mattybrad/bjarkardottir2/README.md

# Bjarkardóttir 2

A synthesizer/guitar hybrid. Somewhere between a MIDI guitar and a synthesizer. Not commercially viable. A time sink. A rabbit hole. An obsession. A mistake. An exercise in blind faith. A reason to tidy the shed. A sequel to a glass cannon.
