mattybrad/bjarkardottir2/cnc/fretboard1.FCStd

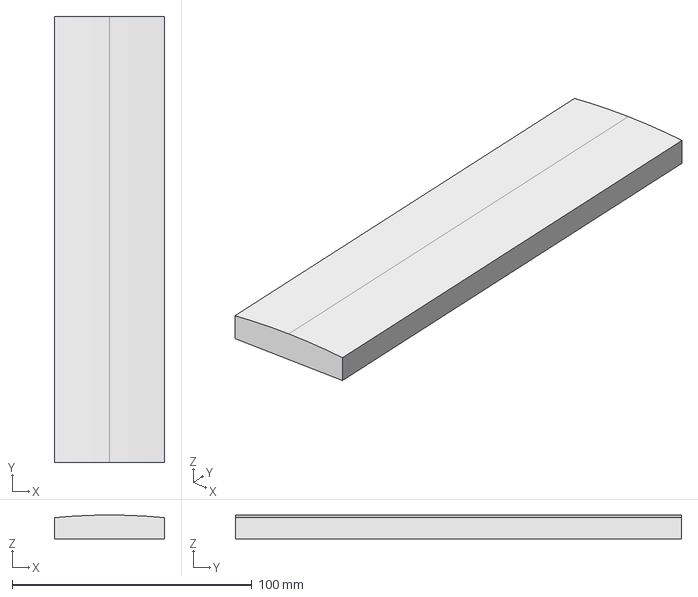
[picture p1: CAD file, 2024-11-12]
cnc/fretboard1.FCStd
46.0 x 186.0 x 10.0 mm
