mattybrad/bjarkardottir2/model/strat_with_pcb.FCStd

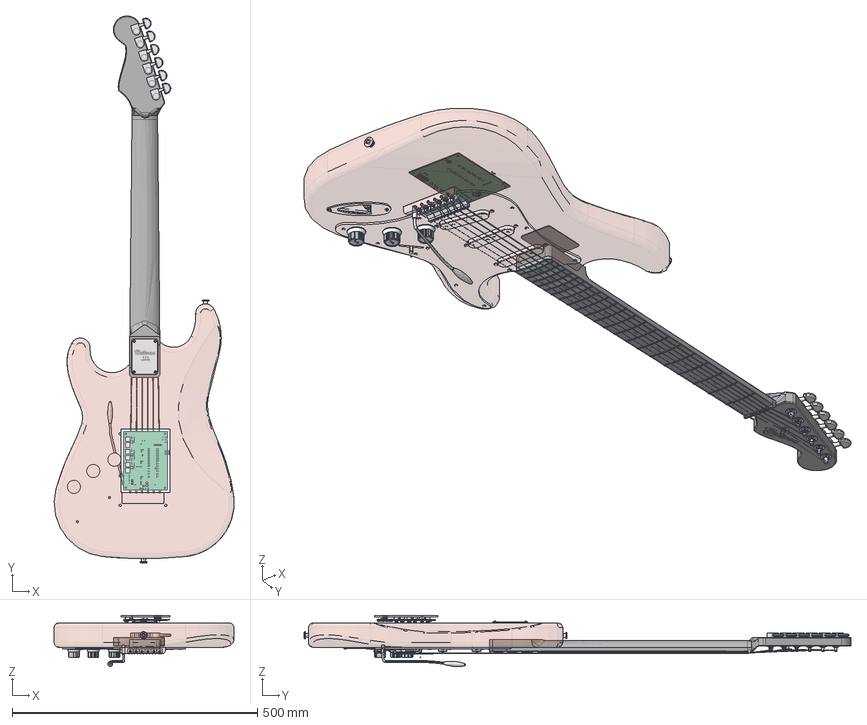
[picture p2: CAD file, 2025-02-05]
model/strat_with_pcb.FCStd
366.5 x 1115.4 x 104.3 mm
Wood
Wood001
Wood002
Neck
Neck001
Neck002
Neck003
Neck004
Neck005
Neck006
Neck007
Neck008
Neck009
Neck010
Neck011
Neck012
Neck013
Neck014
Dryer
Dryer001
Dryer003
Dryer004
Dryer006
Dryer007
Dryer009
Dryer010
Dryer012
Dryer013
Dryer015
Dryer016
Bridge
Bridge001
Bridge002
Bridge003
Bridge004
Bridge005
Peer
Peer001
Peer003
Peer004
Peer006
Peer007
Peer009
Peer010
Peer012
Peer013
Peer015
Peer016
String
String001
String002
String003
String004
String005
Knob2
Knob003
Knob
tREMOLO
Pengait Neck
cover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
