mattybrad/bjarkardottir2/pcb/fretboard/S5B-ZR-SM4A-TF.STEP

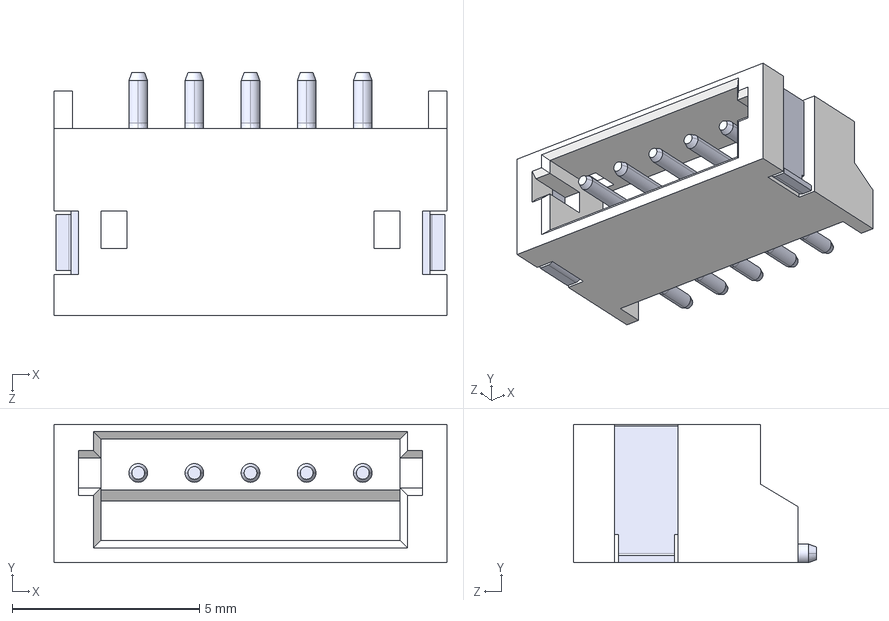
[picture p3: CAD file, 2025-02-12]
pcb/fretboard/S5B-ZR-SM4A-TF.STEP
10.5 x 3.70 x 6.50 mm
