mattybrad/bjarkardottir2/cnc/bridgecnc.FCStd

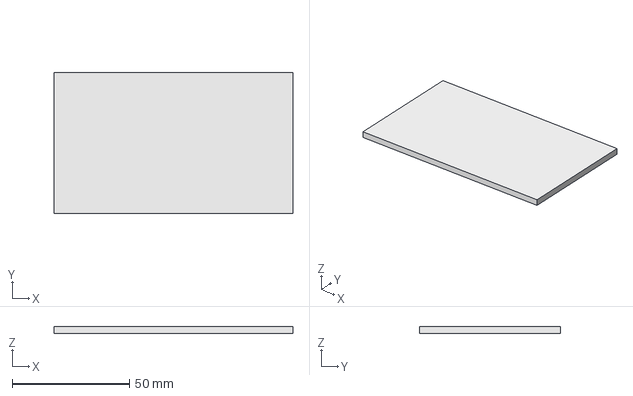
[picture p4: CAD file, 2024-11-12]
cnc/bridgecnc.FCStd
102.0 x 60.0 x 3.00 mm
