mattybrad/bjarkardottir2/cnc/bridge.FCStd

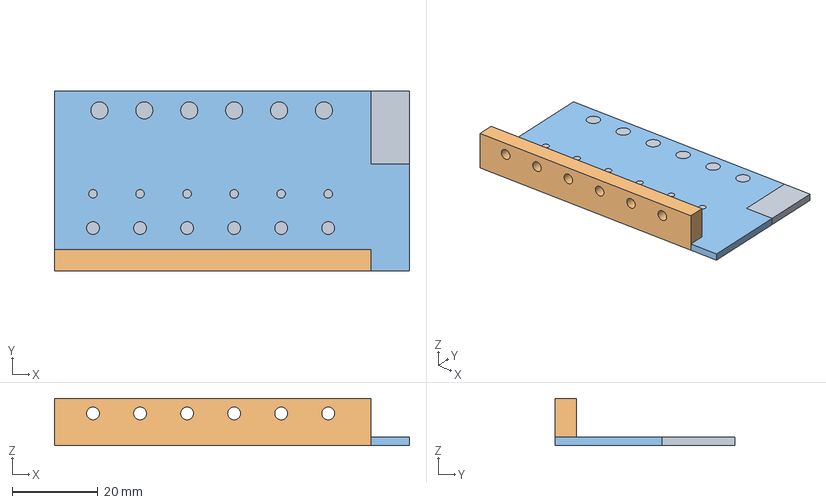
[picture p5: CAD file, 2024-11-12]
cnc/bridge.FCStd
83.0 x 42.0 x 11.0 mm
