mattybrad/bjarkardottir2/(list of files, cad)

Other CAD files:
cnc/bridge.stl
