mattybrad/bjarkardottir2/pcb/body2/body2.kicad_pcb

## KiCad design pcb/body2/body2.kicad_pcb (2025-06-07)

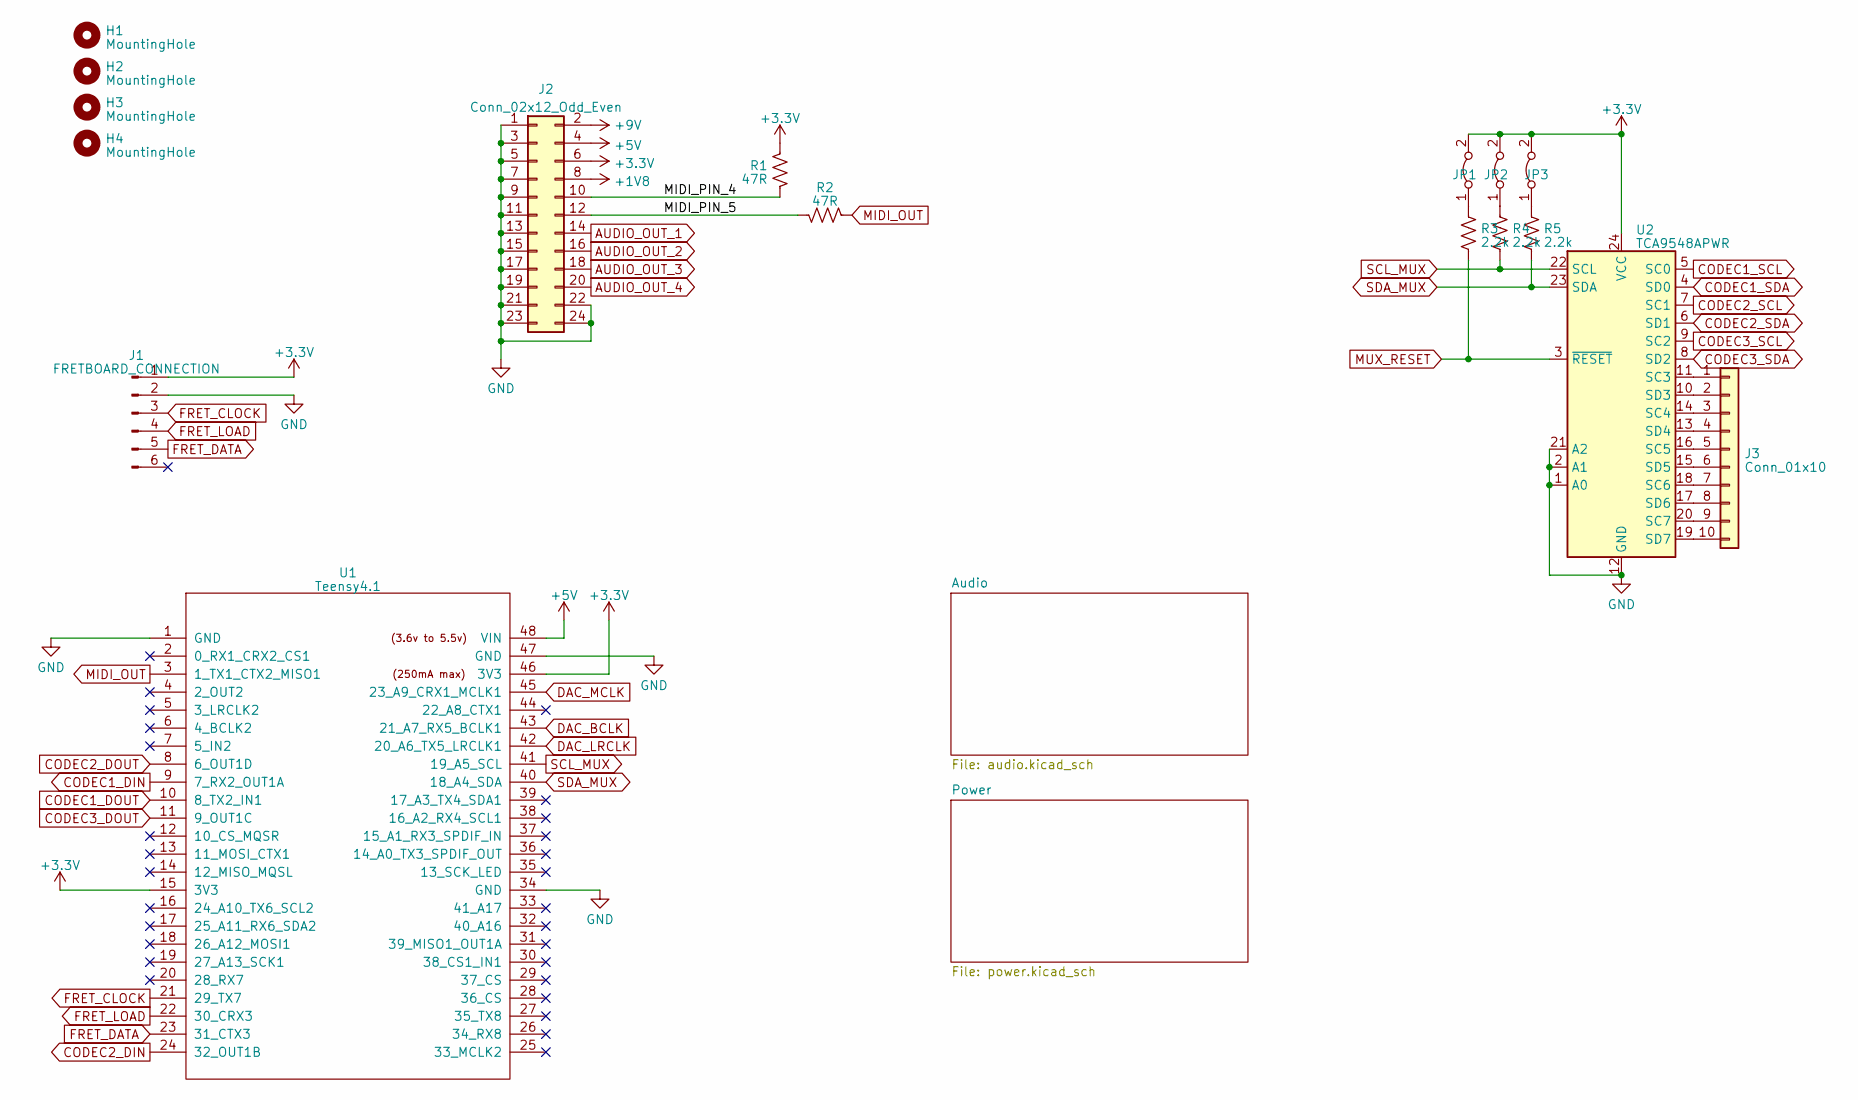
[picture p6: schematic body2.kicad_sch]

Parts:
H1, H2, H3, H4: MountingHole; MountingHole_3.2mm_M3
J1: FRETBOARD_CONNECTION; jst zh fretboard connector; LCSC C485355
J2: Conn_02x12_Odd_Even; PinHeader_2x12_P2.54mm_Vertical
J3: Conn_01x10; PinHeader_1x10_P1.27mm_Vertical
JP1, JP2, JP3: Jumper_2_Bridged; SolderJumper-2_P1.3mm_Bridged_Pad1.0x1.5mm
R1, R2: 47R; R_0603_1608Metric; LCSC C23182
R3, R4, R5: 2.2k; R_0603_1608Metric; LCSC C21190
U1: Teensy4.1; Teensy41_breakout
U2: TCA9548APWR; TSSOP-24_4.4x7.8mm_P0.65mm

Connections:
+1V8: J2.8; also elsewhere on the board
+3.3V: J1.1, J2.6, JP1.2 (B), JP2.2 (B), JP3.2 (B), R1.1, U1.15 (3V3), U1.46 (3V3), U2.24 (VCC); also elsewhere on the board
+5V: J2.4, U1.48 (VIN); also elsewhere on the board
+9V: J2.2; also elsewhere on the board
/MIDI_PIN_4: J2.10, R1.2
/MIDI_PIN_5: J2.12, R2.2
AUDIO_OUT_1: J2.14; also elsewhere on the board
AUDIO_OUT_2: J2.16; also elsewhere on the board
AUDIO_OUT_3: J2.18; also elsewhere on the board
AUDIO_OUT_4: J2.20; also elsewhere on the board
CODEC1_DIN: U1.9 (7_RX2_OUT1A); also elsewhere on the board
CODEC1_DOUT: U1.10 (8_TX2_IN1); also elsewhere on the board
CODEC1_SCL: U2.5 (SC0); also elsewhere on the board
CODEC1_SDA: U2.4 (SD0); also elsewhere on the board
CODEC2_DIN: U1.24 (32_OUT1B); also elsewhere on the board
CODEC2_DOUT: U1.8 (6_OUT1D); also elsewhere on the board
CODEC2_SCL: U2.7 (SC1); also elsewhere on the board
CODEC2_SDA: U2.6 (SD1); also elsewhere on the board
CODEC3_DOUT: U1.11 (9_OUT1C); also elsewhere on the board
CODEC3_SCL: U2.9 (SC2); also elsewhere on the board
CODEC3_SDA: U2.8 (SD2); also elsewhere on the board
DAC_BCLK: U1.43 (21_A7_RX5_BCLK1); also elsewhere on the board
DAC_LRCLK: U1.42 (20_A6_TX5_LRCLK1); also elsewhere on the board
DAC_MCLK: U1.45 (23_A9_CRX1_MCLK1); also elsewhere on the board
FRET_CLOCK: J1.3, U1.21 (29_TX7)
FRET_DATA: J1.5, U1.23 (31_CTX3)
FRET_LOAD: J1.4, U1.22 (30_CRX3)
GND: J1.2, J2.1, J2.3, J2.5, J2.7, J2.9, J2.11, J2.13, J2.15, J2.17, J2.19, J2.21, J2.22, J2.23, J2.24, U1.1 (GND), U1.34 (GND), U1.47 (GND), U2.1 (A0), U2.2 (A1), U2.12 (GND), U2.21 (A2); also elsewhere on the board
MIDI_OUT: R2.1, U1.3 (1_TX1_CTX2_MISO1)
MUX_RESET: R3.1, U2.3 (~RESET)
unnamed: J3.1, U2.11 (SC3)
unnamed: J3.2, U2.10 (SD3)
unnamed: J3.3, U2.14 (SC4)
unnamed: J3.4, U2.13 (SD4)
unnamed: J3.5, U2.16 (SC5)
unnamed: J3.6, U2.15 (SD5)
unnamed: J3.7, U2.18 (SC6)
unnamed: J3.8, U2.17 (SD6)
unnamed: J3.9, U2.20 (SC7)
unnamed: J3.10, U2.19 (SD7)
unnamed: JP1.1 (A), R3.2
unnamed: JP2.1 (A), R4.2
unnamed: JP3.1 (A), R5.2
SCL_MUX: R4.1, U1.41 (19_A5_SCL), U2.22 (SCL)
SDA_MUX: R5.1, U1.40 (18_A4_SDA), U2.23 (SDA)

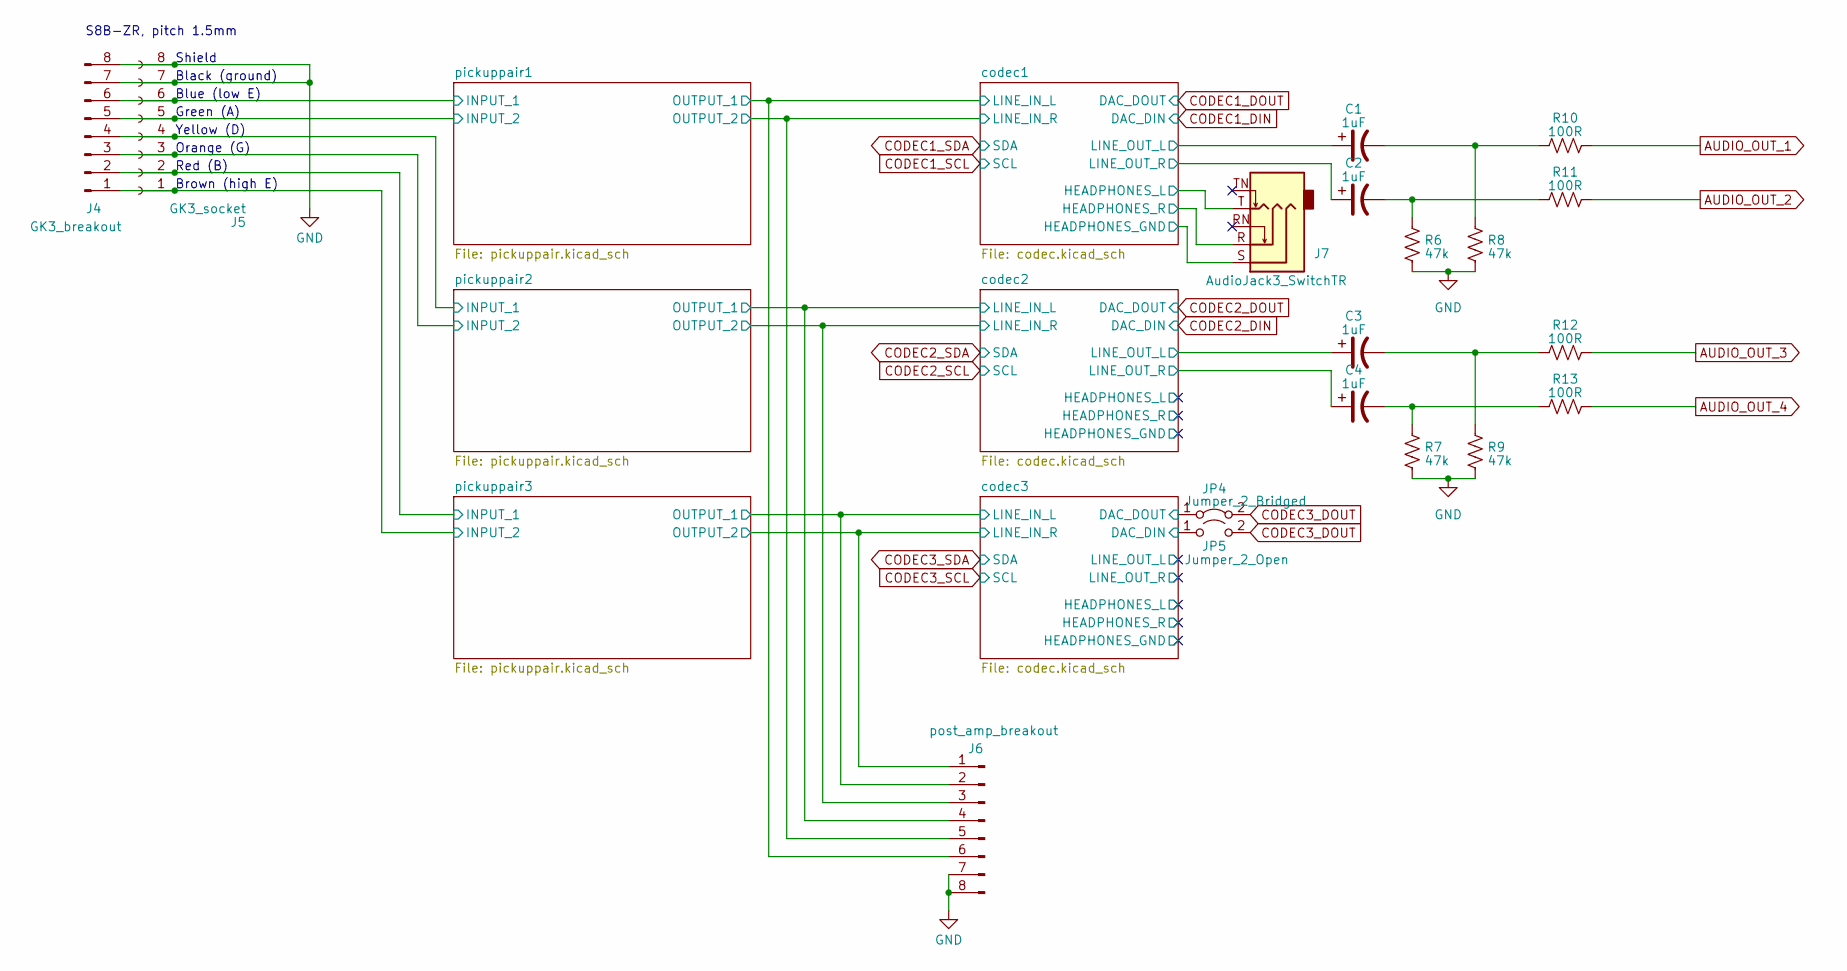
[picture p7: schematic audio.kicad_sch]

Parts:
C1, C3: 1uF; C_0603_1608Metric; LCSC C23630
C2, C4: 1uF; C_0603_1608Metric; LCSC C513735
J4: GK3_breakout; PinHeader_1x08_P2.54mm_Vertical
J5: GK3_socket; gk3 connector THT
J6: post_amp_breakout; PinHeader_1x08_P2.54mm_Vertical
J7: AudioJack3_SwitchTR; Jack_3.5mm_CUI_SJ1-3525N_Horizontal
JP4: Jumper_2_Bridged; SolderJumper-2_P1.3mm_Bridged_Pad1.0x1.5mm
JP5: Jumper_2_Open; SolderJumper-2_P1.3mm_Open_Pad1.0x1.5mm
R6, R7: 47k; R_0603_1608Metric; LCSC C22935
R8, R9: 47k; R_0603_1608Metric; LCSC C22976
R10, R11, R12, R13: 100R; R_0603_1608Metric; LCSC C22976

Connections:
/Audio/codec1/HEADPHONES_GND: J7.S; also elsewhere on the board
/Audio/codec1/HEADPHONES_L: J7.T; also elsewhere on the board
/Audio/codec1/HEADPHONES_R: J7.R; also elsewhere on the board
/Audio/codec1/LINE_IN_L: J6.6; also elsewhere on the board
/Audio/codec1/LINE_IN_R: J6.5; also elsewhere on the board
/Audio/codec1/LINE_OUT_L: C1.1; also elsewhere on the board
/Audio/codec1/LINE_OUT_R: C2.1; also elsewhere on the board
/Audio/codec2/LINE_IN_L: J6.4; also elsewhere on the board
/Audio/codec2/LINE_IN_R: J6.3; also elsewhere on the board
/Audio/codec2/LINE_OUT_L: C3.1; also elsewhere on the board
/Audio/codec2/LINE_OUT_R: C4.1; also elsewhere on the board
/Audio/codec3/DAC_DIN: JP5.1 (A); also elsewhere on the board
/Audio/codec3/DAC_DOUT: JP4.1 (A); also elsewhere on the board
/Audio/codec3/LINE_IN_L: J6.2; also elsewhere on the board
/Audio/codec3/LINE_IN_R: J6.1; also elsewhere on the board
/Audio/pickuppair1/INPUT_1: J4.6, J5.6; also elsewhere on the board
/Audio/pickuppair1/INPUT_2: J4.5, J5.5; also elsewhere on the board
/Audio/pickuppair2/INPUT_1: J4.4, J5.4; also elsewhere on the board
/Audio/pickuppair2/INPUT_2: J4.3, J5.3; also elsewhere on the board
/Audio/pickuppair3/INPUT_1: J4.2, J5.2; also elsewhere on the board
/Audio/pickuppair3/INPUT_2: J4.1, J5.1; also elsewhere on the board
AUDIO_OUT_1: R10.1; also elsewhere on the board
AUDIO_OUT_2: R11.1; also elsewhere on the board
AUDIO_OUT_3: R12.1; also elsewhere on the board
AUDIO_OUT_4: R13.1; also elsewhere on the board
CODEC3_DOUT: JP4.2 (B), JP5.2 (B); also elsewhere on the board
GND: J4.7, J4.8, J5.7, J5.8, J6.7, J6.8, R6.1, R7.1, R8.1, R9.1; also elsewhere on the board
unnamed: C1.2, R8.2, R10.2
unnamed: C2.2, R6.2, R11.2
unnamed: C3.2, R9.2, R12.2
unnamed: C4.2, R7.2, R13.2

Notes on the sheet:
Black (ground)
Yellow (D)
Brown (high E)
Red (B)
Green (A)
Orange (G)
S8B-ZR, pitch 1.5mm
Blue (low E)
Shield

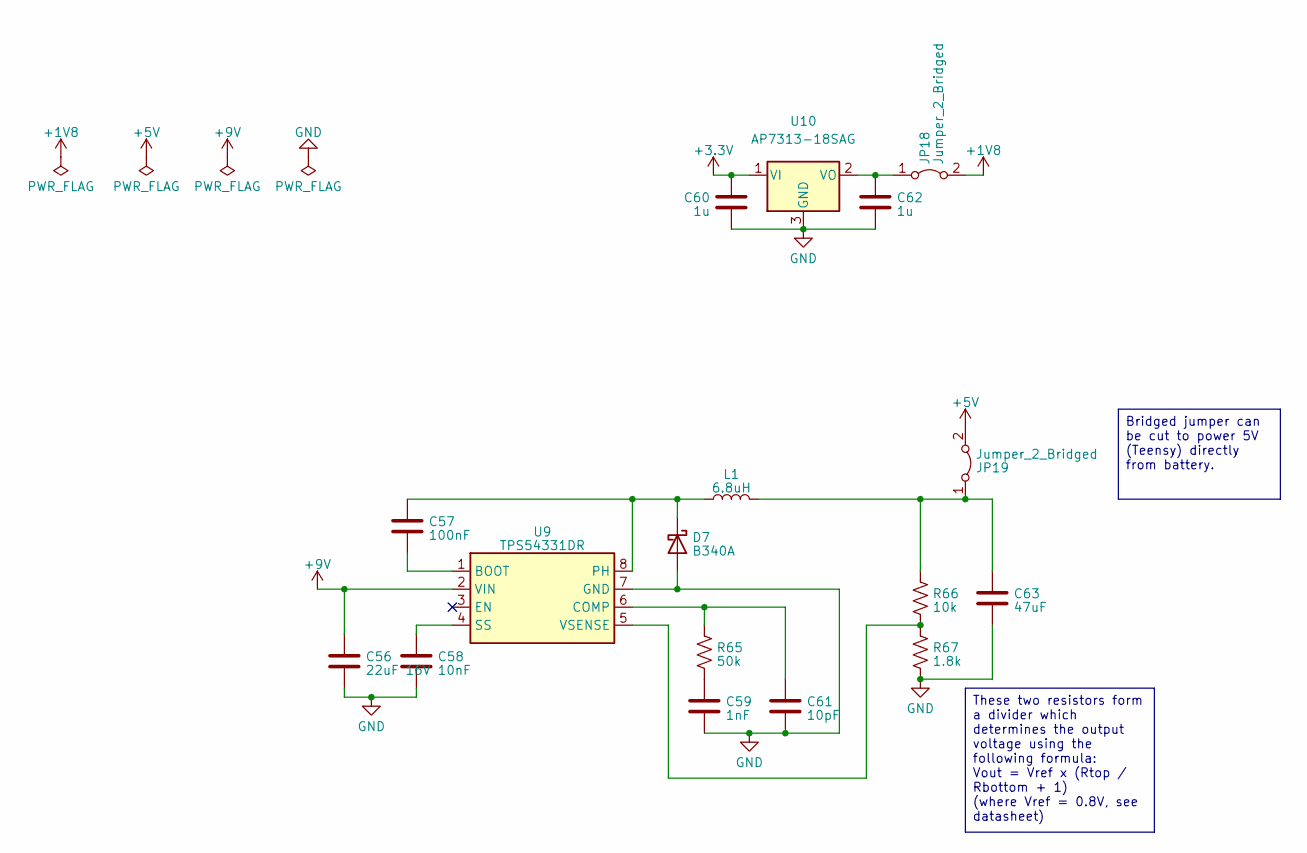
[picture p8: schematic power.kicad_sch]

Parts:
C56: 22uF 16V; C_0805_2012Metric
C57: 100nF; C_0603_1608Metric
C58: 10nF; C_0603_1608Metric
C59: 1nF; C_0603_1608Metric
C60, C62: 1u; C_0603_1608Metric
C61: 10pF; C_0603_1608Metric
C63: 47uF; C_1210_3225Metric
D7: B340A; D_SMA
JP18, JP19: Jumper_2_Bridged; SolderJumper-2_P1.3mm_Bridged_Pad1.0x1.5mm
L1: 6.8uH; L_Changjiang_FNR4020S
R65: 50k; R_0603_1608Metric
R66: 10k; R_0603_1608Metric
R67: 1.8k; R_0603_1608Metric
U9: TPS54331DR; SOIC-8_3.9x4.9mm_P1.27mm
U10: AP7313-18SAG; SOT-23

Connections:
+1V8: JP18.2 (B); also elsewhere on the board
+3.3V: C60.1, U10.1 (VI); also elsewhere on the board
+5V: JP19.2 (B); also elsewhere on the board
+9V: C56.1, U9.2 (VIN); also elsewhere on the board
GND: C56.2, C58.2, C59.2, C60.2, C61.2, C62.2, C63.2, D7.2 (A), R67.2, U9.7 (GND), U10.3 (GND); also elsewhere on the board
unnamed: C59.1, R65.2
unnamed: C57.1, D7.1 (K), L1.1, U9.8 (PH)
unnamed: C62.1, JP18.1 (A), U10.2 (VO)
unnamed: C63.1, JP19.1 (A), L1.2, R66.1
unnamed: C57.2, U9.1 (BOOT)
unnamed: C61.1, R65.1, U9.6 (COMP)
unnamed: C58.1, U9.4 (SS)
unnamed: R66.2, R67.1, U9.5 (VSENSE)

Notes on the sheet:
Bridged jumper can be cut to power 5V (Teensy) directly from battery.
These two resistors form a divider which determines the output voltage using the following formula: Vout = Vref x (Rtop / Rbottom + 1) (where Vref = 0.8V, see datasheet)

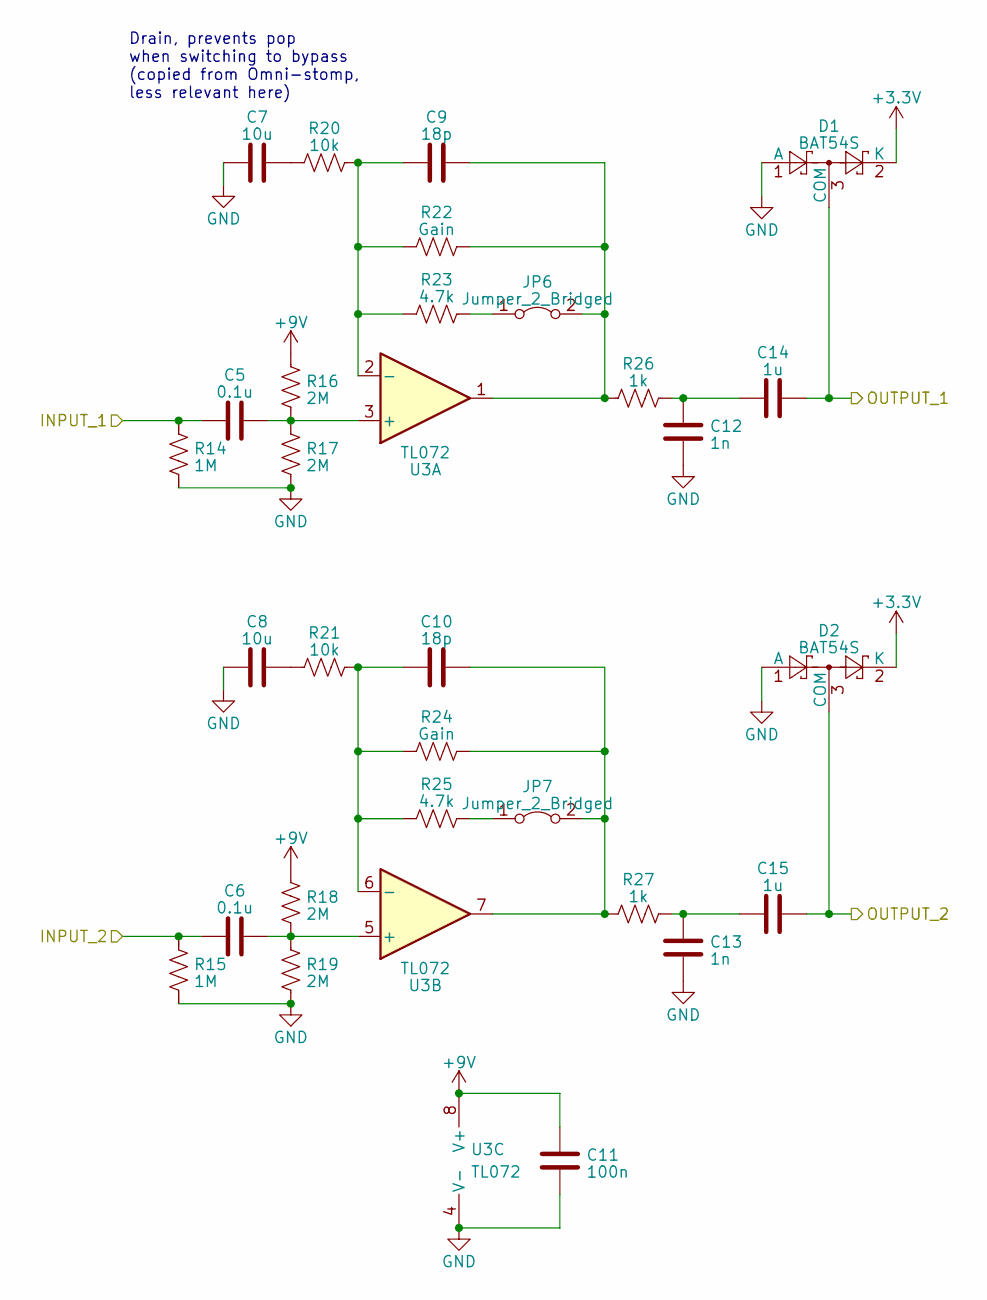
[picture p9: schematic pickuppair.kicad_sch]

Parts:
C5, C6: 0.1u; C_0603_1608Metric
C7, C8: 10u; C_0603_1608Metric
C9, C10: 18p; C_0603_1608Metric
C11: 100n; C_0603_1608Metric
C12, C13: 1n; C_0603_1608Metric
C14, C15: 1u; C_0603_1608Metric
D1, D2: BAT54S; SOT-23
JP6, JP7: Jumper_2_Bridged; SolderJumper-2_P1.3mm_Bridged_Pad1.0x1.5mm
R14, R15: 1M; R_0603_1608Metric
R16, R17, R18, R19: 2M; R_0603_1608Metric
R20, R21: 10k; R_0603_1608Metric
R22, R24: Gain; R_Axial_DIN0207_L6.3mm_D2.5mm_P7.62mm_Horizontal
R23, R25: 4.7k; R_0603_1608Metric
R26, R27: 1k; R_0603_1608Metric
U3: TL072; SOIC-8_3.9x4.9mm_P1.27mm

Connections:
+3.3V: D1.2 (K), D2.2 (K); also elsewhere on the board
+9V: C11.2, R16.1, R18.1, U3.8 (V+); also elsewhere on the board
/Audio/codec1/LINE_IN_L: C14.1, D1.3 (COM); also elsewhere on the board
/Audio/codec1/LINE_IN_R: C15.1, D2.3 (COM); also elsewhere on the board
/Audio/pickuppair1/INPUT_1: C5.1, R14.1; also elsewhere on the board
/Audio/pickuppair1/INPUT_2: C6.1, R15.1; also elsewhere on the board
GND: C7.1, C8.1, C11.1, C12.2, C13.2, D1.1 (A), D2.1 (A), R14.2, R15.2, R17.2, R19.2, U3.4 (V-); also elsewhere on the board
unnamed: C7.2, R20.1
unnamed: C8.2, R21.1
unnamed: C12.1, C14.2, R26.2
unnamed: C13.1, C15.2, R27.2
unnamed: JP6.1 (A), R23.2
unnamed: C9.2, JP6.2 (B), R22.2, R26.1, U3.1
unnamed: JP7.1 (A), R25.2
unnamed: C10.2, JP7.2 (B), R24.2, R27.1, U3.7
unnamed: C5.2, R16.2, R17.1, U3.3 (+)
unnamed: C9.1, R20.2, R22.1, R23.1, U3.2 (-)
unnamed: C6.2, R18.2, R19.1, U3.5 (+)
unnamed: C10.1, R21.2, R24.1, R25.1, U3.6 (-)

Parts of its further copies:
C18, C19, C29, C30: 10u; C_0603_1608Metric
C20, C21, C31, C32: 18p; C_0603_1608Metric
C22, C33: 100n; C_0603_1608Metric
C23, C24, C34, C35: 1n; C_0603_1608Metric
C25, C26, C36, C37: 1u; C_0603_1608Metric
C27, C28: 0.1u; C_0603_1608Metric
D3, D4, D5, D6: BAT54S; SOT-23
JP8, JP9, JP10, JP11: Jumper_2_Bridged; SolderJumper-2_P1.3mm_Bridged_Pad1.0x1.5mm
R28, R29, R42, R43: 1M; R_0603_1608Metric
R30, R31, R32, R33, R44, R45, R46, R47: 2M; R_0603_1608Metric
R34, R35, R48, R49: 10k; R_0603_1608Metric
R36, R38, R50, R52: Gain; R_Axial_DIN0207_L6.3mm_D2.5mm_P7.62mm_Horizontal
R37, R39, R51, R53: 4.7k; R_0603_1608Metric
R40, R41, R54, R55: 1k; R_0603_1608Metric
U4, U5: TL072; SOIC-8_3.9x4.9mm_P1.27mm

Connections of its further copies:
+3.3V: D3.2 (K), D4.2 (K), D5.2 (K), D6.2 (K); also elsewhere on the board
+9V: C22.2, C33.2, R30.1, R32.1, R44.1, R46.1, U4.8 (V+), U5.8 (V+); also elsewhere on the board
/Audio/codec2/LINE_IN_L: C25.1, D3.3 (COM); also elsewhere on the board
/Audio/codec2/LINE_IN_R: C26.1, D4.3 (COM); also elsewhere on the board
/Audio/codec3/LINE_IN_L: C36.1, D5.3 (COM); also elsewhere on the board
/Audio/codec3/LINE_IN_R: C37.1, D6.3 (COM); also elsewhere on the board
/Audio/pickuppair2/INPUT_1: R28.1; also elsewhere on the board
/Audio/pickuppair2/INPUT_2: R29.1; also elsewhere on the board
/Audio/pickuppair3/INPUT_1: C27.1, R42.1; also elsewhere on the board
/Audio/pickuppair3/INPUT_2: C28.1, R43.1; also elsewhere on the board
GND: C18.1, C19.1, C22.1, C23.2, C24.2, C29.1, C30.1, C33.1, C34.2, C35.2, D3.1 (A), D4.1 (A), D5.1 (A), D6.1 (A), R28.2, R29.2, R31.2, R33.2, R42.2, R43.2, R45.2, R47.2, U4.4 (V-), U5.4 (V-); also elsewhere on the board
unnamed: C18.2, R34.1
unnamed: C19.2, R35.1
unnamed: C23.1, C25.2, R40.2
unnamed: C24.1, C26.2, R41.2
unnamed: C29.2, R48.1
unnamed: C30.2, R49.1
unnamed: C34.1, C36.2, R54.2
unnamed: C35.1, C37.2, R55.2
unnamed: JP8.1 (A), R37.2
unnamed: C20.2, JP8.2 (B), R36.2, R40.1, U4.1
unnamed: JP9.1 (A), R39.2
unnamed: C21.2, JP9.2 (B), R38.2, R41.1, U4.7
unnamed: JP10.1 (A), R51.2
unnamed: C31.2, JP10.2 (B), R50.2, R54.1, U5.1
unnamed: JP11.1 (A), R53.2
unnamed: C32.2, JP11.2 (B), R52.2, R55.1, U5.7
unnamed 114: R30.2, R31.1, U4.3 (+); also elsewhere on the board
unnamed: C20.1, R34.2, R36.1, R37.1, U4.2 (-)
unnamed 116: R32.2, R33.1, U4.5 (+); also elsewhere on the board
unnamed: C21.1, R35.2, R38.1, R39.1, U4.6 (-)
unnamed: C27.2, R44.2, R45.1, U5.3 (+)
unnamed: C31.1, R48.2, R50.1, R51.1, U5.2 (-)
unnamed: C28.2, R46.2, R47.1, U5.5 (+)
unnamed: C32.1, R49.2, R52.1, R53.1, U5.6 (-)

Notes on the sheet:
Drain, prevents pop when switching to bypass (copied from Omni-stomp, less relevant here)

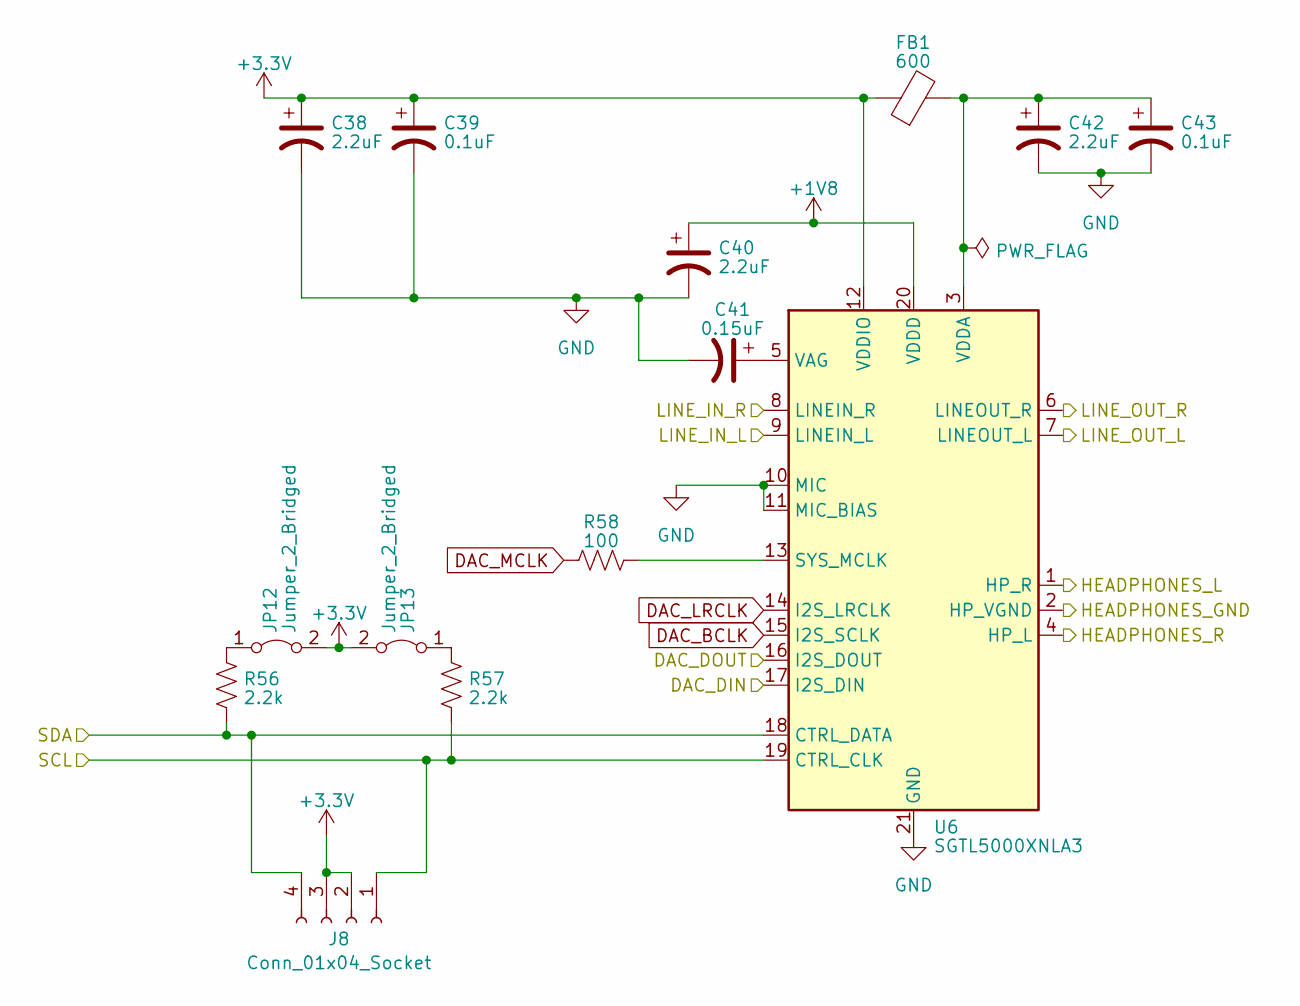
[picture p10: schematic codec.kicad_sch]

Parts:
C38, C40, C42: 2.2uF; C_0603_1608Metric
C39, C43: 0.1uF; C_0603_1608Metric
C41: 0.15uF; C_0603_1608Metric
FB1: 600; L_0603_1608Metric
J8: Conn_01x04_Socket; PinSocket_1x04_P1.27mm_Vertical
JP12, JP13: Jumper_2_Bridged; SolderJumper-2_P1.3mm_Bridged_Pad1.0x1.5mm
R56, R57: 2.2k; R_0603_1608Metric; LCSC C21190
R58: 100; R_0603_1608Metric
U6: SGTL5000XNLA3; QFN-20-1EP_3x3mm_P0.4mm_EP1.65x1.65mm

Connections:
+1V8: C40.1, U6.20 (VDDD); also elsewhere on the board
+3.3V: C38.1, C39.1, FB1.1, J8.2, J8.3, JP12.2 (B), JP13.2 (B), U6.12 (VDDIO); also elsewhere on the board
/Audio/codec1/HEADPHONES_GND: U6.2 (HP_VGND); also elsewhere on the board
/Audio/codec1/HEADPHONES_L: U6.1 (HP_R); also elsewhere on the board
/Audio/codec1/HEADPHONES_R: U6.4 (HP_L); also elsewhere on the board
/Audio/codec1/LINE_IN_L: U6.9 (LINEIN_L); also elsewhere on the board
/Audio/codec1/LINE_IN_R: U6.8 (LINEIN_R); also elsewhere on the board
/Audio/codec1/LINE_OUT_L: U6.7 (LINEOUT_L); also elsewhere on the board
/Audio/codec1/LINE_OUT_R: U6.6 (LINEOUT_R); also elsewhere on the board
CODEC1_DIN: U6.17 (I2S_DIN); also elsewhere on the board
CODEC1_DOUT: U6.16 (I2S_DOUT); also elsewhere on the board
CODEC1_SCL: J8.1, R57.1, U6.19 (CTRL_CLK); also elsewhere on the board
CODEC1_SDA: J8.4, R56.1, U6.18 (CTRL_DATA); also elsewhere on the board
DAC_BCLK: U6.15 (I2S_SCLK); also elsewhere on the board
DAC_LRCLK: U6.14 (I2S_LRCLK); also elsewhere on the board
DAC_MCLK: R58.2; also elsewhere on the board
GND: C38.2, C39.2, C40.2, C41.2, C42.2, C43.2, U6.10 (MIC), U6.11 (MIC_BIAS), U6.21 (GND); also elsewhere on the board
unnamed: JP12.1 (A), R56.2
unnamed: JP13.1 (A), R57.2
unnamed: R58.1, U6.13 (SYS_MCLK)
unnamed: C41.1, U6.5 (VAG)
unnamed: C42.1, C43.1, FB1.2, U6.3 (VDDA)

Parts of its further copies:
C44, C46, C48, C50, C52, C54: 2.2uF; C_0603_1608Metric
C45, C49, C51, C55: 0.1uF; C_0603_1608Metric
C47, C53: 0.15uF; C_0603_1608Metric
FB2, FB3: 600; L_0603_1608Metric
J9, J10: Conn_01x04_Socket; PinSocket_1x04_P1.27mm_Vertical
JP14, JP15, JP16, JP17: Jumper_2_Bridged; SolderJumper-2_P1.3mm_Bridged_Pad1.0x1.5mm
R59, R60, R62, R63: 2.2k; R_0603_1608Metric; LCSC C21190
R61, R64: 100; R_0603_1608Metric
U7, U8: SGTL5000XNLA3; QFN-20-1EP_3x3mm_P0.4mm_EP1.65x1.65mm

Connections of its further copies:
+1V8: C46.1, C52.1, U7.20 (VDDD), U8.20 (VDDD); also elsewhere on the board
+3.3V: C44.1, C45.1, C50.1, C51.1, FB2.1, FB3.1, J9.2, J9.3, J10.2, J10.3, JP14.2 (B), JP15.2 (B), JP16.2 (B), JP17.2 (B), U7.12 (VDDIO), U8.12 (VDDIO); also elsewhere on the board
/Audio/codec2/HEADPHONES_GND: U7.2 (HP_VGND)
/Audio/codec2/HEADPHONES_L: U7.1 (HP_R)
/Audio/codec2/HEADPHONES_R: U7.4 (HP_L)
/Audio/codec2/LINE_IN_L: U7.9 (LINEIN_L); also elsewhere on the board
/Audio/codec2/LINE_IN_R: U7.8 (LINEIN_R); also elsewhere on the board
/Audio/codec2/LINE_OUT_L: U7.7 (LINEOUT_L); also elsewhere on the board
/Audio/codec2/LINE_OUT_R: U7.6 (LINEOUT_R); also elsewhere on the board
/Audio/codec3/DAC_DIN: U8.17 (I2S_DIN); also elsewhere on the board
/Audio/codec3/DAC_DOUT: U8.16 (I2S_DOUT); also elsewhere on the board
/Audio/codec3/HEADPHONES_GND: U8.2 (HP_VGND)
/Audio/codec3/HEADPHONES_L: U8.1 (HP_R)
/Audio/codec3/HEADPHONES_R: U8.4 (HP_L)
/Audio/codec3/LINE_IN_L: U8.9 (LINEIN_L); also elsewhere on the board
/Audio/codec3/LINE_IN_R: U8.8 (LINEIN_R); also elsewhere on the board
/Audio/codec3/LINE_OUT_L: U8.7 (LINEOUT_L)
/Audio/codec3/LINE_OUT_R: U8.6 (LINEOUT_R)
CODEC2_DIN: U7.17 (I2S_DIN); also elsewhere on the board
CODEC2_DOUT: U7.16 (I2S_DOUT); also elsewhere on the board
CODEC2_SCL: J9.1, R60.1, U7.19 (CTRL_CLK); also elsewhere on the board
CODEC2_SDA: J9.4, R59.1, U7.18 (CTRL_DATA); also elsewhere on the board
CODEC3_SCL: J10.1, R63.1, U8.19 (CTRL_CLK); also elsewhere on the board
CODEC3_SDA: J10.4, R62.1, U8.18 (CTRL_DATA); also elsewhere on the board
DAC_BCLK: U7.15 (I2S_SCLK), U8.15 (I2S_SCLK); also elsewhere on the board
DAC_LRCLK: U7.14 (I2S_LRCLK), U8.14 (I2S_LRCLK); also elsewhere on the board
DAC_MCLK: R61.2, R64.2; also elsewhere on the board
GND: C44.2, C45.2, C46.2, C47.2, C48.2, C49.2, C50.2, C51.2, C52.2, C53.2, C54.2, C55.2, U7.10 (MIC), U7.11 (MIC_BIAS), U7.21 (GND), U8.10 (MIC), U8.11 (MIC_BIAS), U8.21 (GND); also elsewhere on the board
unnamed: JP14.1 (A), R59.2
unnamed: JP15.1 (A), R60.2
unnamed: JP16.1 (A), R62.2
unnamed: JP17.1 (A), R63.2
unnamed: R61.1, U7.13 (SYS_MCLK)
unnamed: C47.1, U7.5 (VAG)
unnamed: C48.1, C49.1, FB2.2, U7.3 (VDDA)
unnamed: R64.1, U8.13 (SYS_MCLK)
unnamed: C53.1, U8.5 (VAG)
unnamed: C54.1, C55.1, FB3.2, U8.3 (VDDA)

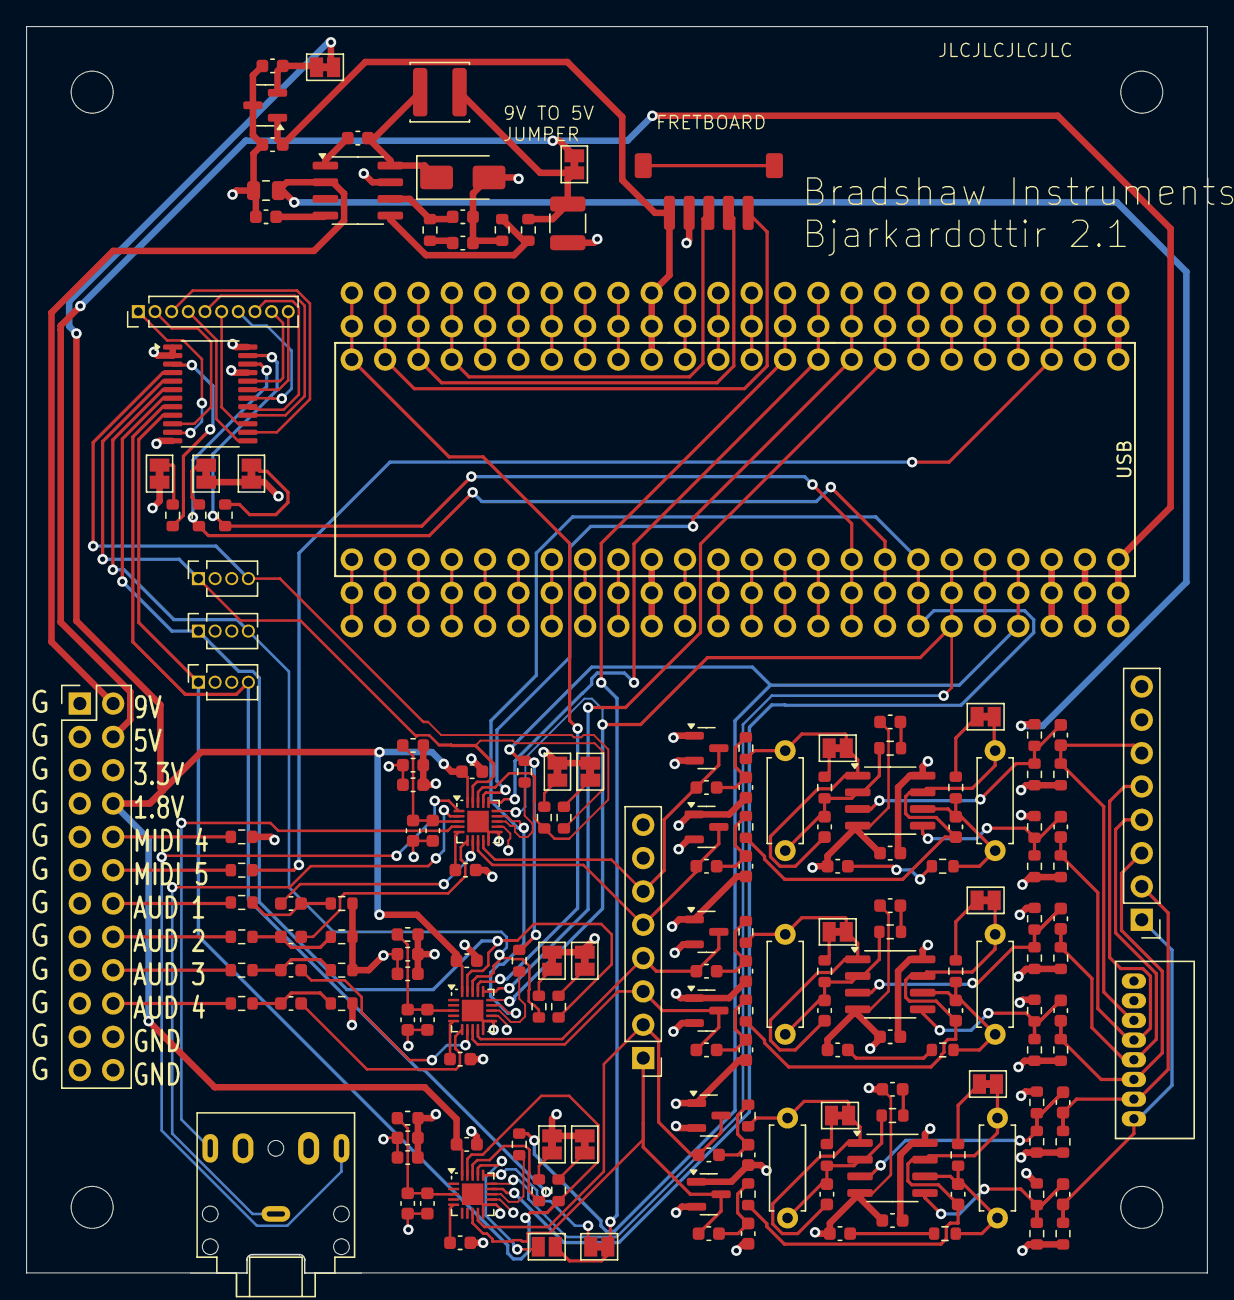
[picture p11: board body2.kicad_pcb from above]

Board: 4 copper layers, 90.0 x 95.0 mm, 184 parts (0 on the bottom side), 129 nets.

Other parts of the board:
C16, C17: 0.1u; C_0603_1608Metric

Their connections:
/Audio/pickuppair2/INPUT_1: C16.1; also elsewhere on the board
/Audio/pickuppair2/INPUT_2: C17.1; also elsewhere on the board
unnamed 114: C16.2; also elsewhere on the board
unnamed 116: C17.2; also elsewhere on the board
