mattybrad/bjarkardottir2/pcb/body/body.kicad_pcb

## KiCad design pcb/body/body.kicad_pcb (2025-02-17)

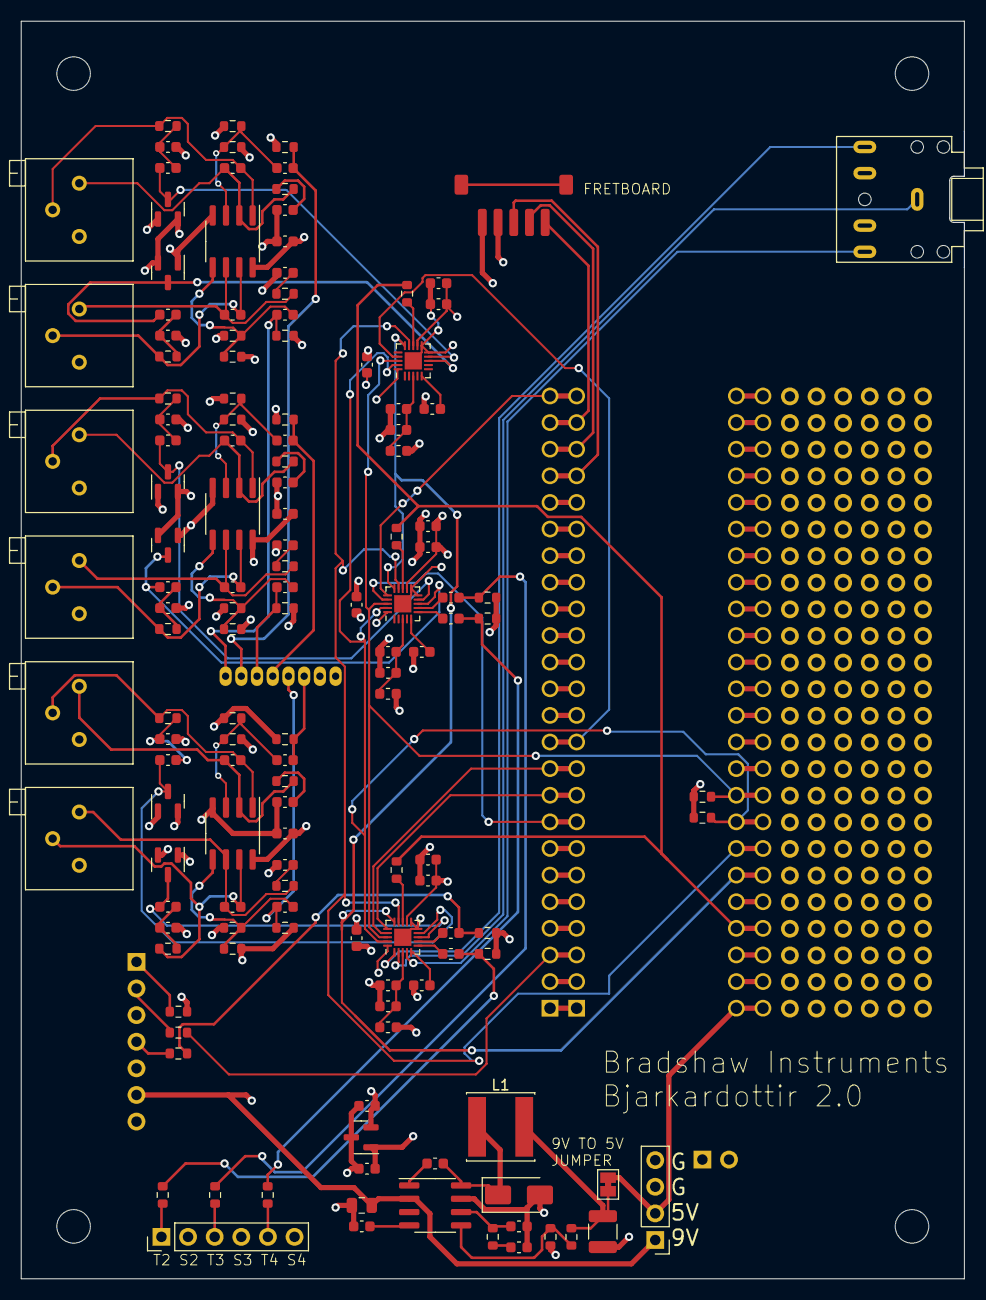
[picture p12: board body.kicad_pcb from above]

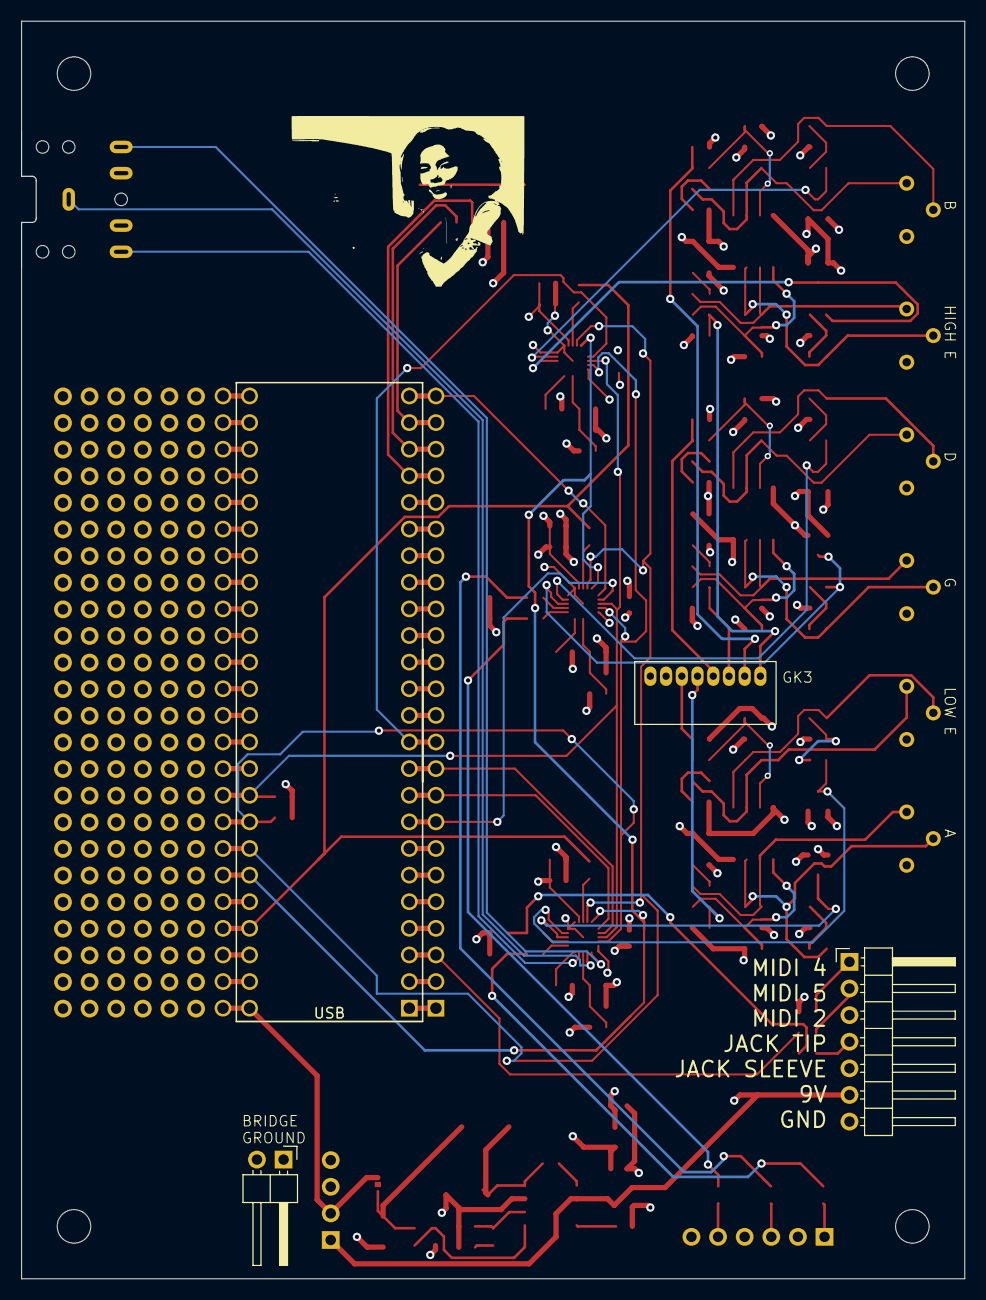
[picture p13: board body.kicad_pcb from below]

Board: 4 copper layers, 90.0 x 120.0 mm, 293 parts (4 on the bottom side), 94 nets.

Parts:
C1, C2, C3, C4: 1uF; C_0603_1608Metric
C5, C6, C16, C17, C27, C28: 0.1u; C_0603_1608Metric
C7, C8, C18, C19, C29, C30: 10u; C_0603_1608Metric
C9, C10, C20, C21, C31, C32: 18p; C_0603_1608Metric
C11, C22, C33: 100n; C_0603_1608Metric
C12, C13, C23, C24, C34, C35: 1n; C_0603_1608Metric
C14, C15, C25, C26, C36, C37, C60, C62: 1u; C_0603_1608Metric
C38, C40, C42, C44, C46, C48, C50, C52, C54: 2.2uF; C_0603_1608Metric
C39, C43, C45, C49, C51, C55: 0.1uF; C_0603_1608Metric
C41, C47, C53: 0.15uF; C_0603_1608Metric
C56: 22uF 16V; C_0805_2012Metric
C57: 100nF; C_0603_1608Metric
C58: 10nF; C_0603_1608Metric
C59: 1nF; C_0603_1608Metric
C61: 10pF; C_0603_1608Metric
C63: 47uF; C_1210_3225Metric
D1, D2, D3, D4, D5, D6: BAT54S; SOT-23
D7: B340A; D_SMA
FB1, FB2, FB3: 600; L_0603_1608Metric
H1, H2, H3, H4: MountingHole; MountingHole_3.2mm_M3
J1: FRETBOARD_CONNECTION; jst zh fretboard connector
J2: BRIDGE_GROUND; PinHeader_1x02_P2.54mm_Horizontal
J3: GK3_socket; gk3 connector THT
J4: AudioJack3_SwitchTR; Jack_3.5mm_CUI_SJ1-3525N_Horizontal
J5: External_connections; PinHeader_1x07_P2.54mm_Horizontal
J6: OUTPUTS_234; PinHeader_1x06_P2.54mm_Vertical
J7: Battery_Power; PinHeader_1x04_P2.54mm_Vertical
JP1: Jumper_2_Bridged; SolderJumper-2_P1.3mm_Bridged_Pad1.0x1.5mm
L1: 6.8uH; L_Sunlord_SWPA6045S
PB1, PB2, PB3, PB4, PB5, PB6, PB7, PB8, PB9, PB10, PB11, PB12, PB13, PB14, PB15, PB16, PB17, PB18, PB19, PB20, PB21, PB22, PB23, PB24, PB25, PB26, PB27, PB28, PB29, PB30, PB31, PB32, PB33, PB34, PB35, PB36, PB37, PB38, PB39, PB40, PB41, PB42, PB43, PB44, PB45, PB46, PB47, PB48, PB49, PB50, PB51, PB52, PB53, PB54, PB55, PB56, PB57, PB58, PB59, PB60, PB61, PB62, PB63, PB64, PB65, PB66, PB67, PB68, PB69, PB70, PB71, PB72, PB73, PB74, PB75, PB76, PB77, PB78, PB79, PB80, PB81, PB82, PB83, PB84, PB85, PB86, PB87, PB88, PB89, PB90, PB91, PB92, PB93, PB94, PB95, PB96, PB97, PB98, PB99, PB100, PB101, PB102, PB103, PB104, PB105, PB106, PB107, PB108, PB109, PB110, PB111, PB112, PB113, PB114, PB115, PB116, PB117, PB118, PB119, PB120, PB121, PB122, PB123, PB124, PB125, PB126, PB127, PB128, PB129, PB130, PB131, PB132, PB133, PB134, PB135, PB136, PB137, PB138, PB139, PB140, PB141, PB142, PB143, PB144: perfboard_pin; perfboard pin
R1, R2: 2.2k; R_0603_1608Metric
R3, R4, R6, R7: 47k; R_0603_1608Metric
R5, R8: 47R; R_0603_1608Metric
R9, R10, R11, R12: 100R; R_0603_1608Metric
R13, R14, R23, R24, R33, R34: 1M; R_0603_1608Metric
R15, R16, R17, R18, R25, R26, R27, R28, R35, R36, R37, R38: 2M; R_0603_1608Metric
R19, R20, R29, R30, R39, R40, R47: 10k; R_0603_1608Metric
R21, R22, R31, R32, R41, R42: 1k; R_0603_1608Metric
R43, R44, R45: 100; R_0603_1608Metric
R46: 50k; R_0603_1608Metric
R48: 1.8k; R_0603_1608Metric
RV1, RV2, RV3, RV4, RV5, RV6: 10k; Potentiometer_Bourns_3296P_Horizontal
U1: Teensy4.1; Teensy41_breakout
U2, U3, U4: TL072; SOIC-8_3.9x4.9mm_P1.27mm
U5, U6, U7: SGTL5000XNLA3; QFN-20-1EP_3x3mm_P0.4mm_EP1.65x1.65mm
U8: TPS54331DR; SOIC-8_3.9x4.9mm_P1.27mm
U9: AP7313-18SAG; SOT-23

Connections:
+1V8: C40.1, C46.1, C52.1, C62.1, U5.20 (VDDD), U6.20 (VDDD), U7.20 (VDDD), U9.2 (VO)
+3.3V: C38.1, C39.1, C44.1, C45.1, C50.1, C51.1, C60.1, D1.2 (K), D2.2 (K), D3.2 (K), D4.2 (K), D5.2 (K), D6.2 (K), FB1.1, FB2.1, FB3.1, J1.1, R1.2, R2.2, R5.1, U1.15 (3V3), U1.46 (3V3), U5.12 (VDDIO), U6.12 (VDDIO), U7.12 (VDDIO), U9.1 (VI)
+5V: J7.2, JP1.2 (B), U1.48 (VIN)
+9V: C11.2, C22.2, C33.2, C56.1, J5.6, J7.1, R15.1, R17.1, R25.1, R27.1, R35.1, R37.1, U2.8 (V+), U3.8 (V+), U4.8 (V+), U8.2 (VIN)
/MIDI_PIN_4: J5.1, R5.2
/MIDI_PIN_5: J5.2, R8.2
/codec1/HEADPHONES_GND: J4.S, U5.2 (HP_VGND)
/codec1/HEADPHONES_L: J4.T, U5.1 (HP_R)
/codec1/HEADPHONES_R: J4.R, U5.4 (HP_L)
/codec1/LINE_IN_L: C14.1, D1.3 (COM), U5.9 (LINEIN_L)
/codec1/LINE_IN_R: C15.1, D2.3 (COM), U5.8 (LINEIN_R)
/codec1/LINE_OUT_L: C1.1, U5.7 (LINEOUT_L)
/codec1/LINE_OUT_R: C2.1, U5.6 (LINEOUT_R)
/codec2/LINE_IN_L: C25.1, D3.3 (COM), U6.9 (LINEIN_L)
/codec2/LINE_IN_R: C26.1, D4.3 (COM), U6.8 (LINEIN_R)
/codec2/LINE_OUT_L: C3.1, U6.7 (LINEOUT_L)
/codec2/LINE_OUT_R: C4.1, U6.6 (LINEOUT_R)
/codec3/LINE_IN_L: C36.1, D5.3 (COM), U7.9 (LINEIN_L)
/codec3/LINE_IN_R: C37.1, D6.3 (COM), U7.8 (LINEIN_R)
/pickuppair1/INPUT_1: C5.1, J3.3, R13.1
/pickuppair1/INPUT_2: C6.1, J3.4, R14.1
/pickuppair2/INPUT_1: C16.1, J3.5, R23.1
/pickuppair2/INPUT_2: C17.1, J3.6, R24.1
/pickuppair3/INPUT_1: C27.1, J3.7, R33.1
/pickuppair3/INPUT_2: C28.1, J3.8, R34.1
CODEC1_DIN: U1.10 (8_TX2_IN1), U5.17 (I2S_DIN)
CODEC1_DOUT: U1.9 (7_RX2_OUT1A), U5.16 (I2S_DOUT)
CODEC2_DIN: U1.8 (6_OUT1D), U6.17 (I2S_DIN)
CODEC2_DOUT: U1.24 (32_OUT1B), U6.16 (I2S_DOUT)
CODEC3_DIN: U1.11 (9_OUT1C), U7.17 (I2S_DIN)
DAC_BCLK: U1.43 (21_A7_RX5_BCLK1), U5.15 (I2S_SCLK), U6.15 (I2S_SCLK), U7.15 (I2S_SCLK)
DAC_LRCLK: U1.42 (20_A6_TX5_LRCLK1), U5.14 (I2S_LRCLK), U6.14 (I2S_LRCLK), U7.14 (I2S_LRCLK)
DAC_MCLK: R43.2, R44.2, R45.2, U1.45 (23_A9_CRX1_MCLK1)
DAC_SCL: R1.1, U1.41 (19_A5_SCL), U5.19 (CTRL_CLK), U6.19 (CTRL_CLK), U7.19 (CTRL_CLK)
DAC_SDA: R2.1, U1.40 (18_A4_SDA), U5.18 (CTRL_DATA), U6.18 (CTRL_DATA), U7.18 (CTRL_DATA)
FRET_CLOCK: J1.3, U1.21 (29_TX7)
FRET_DATA: J1.5, U1.23 (31_CTX3)
FRET_LOAD: J1.4, U1.22 (30_CRX3)
GND: C7.1, C8.1, C11.1, C12.2, C13.2, C18.1, C19.1, C22.1, C23.2, C24.2, C29.1, C30.1, C33.1, C34.2, C35.2, C38.2, C39.2, C40.2, C41.2, C42.2, C43.2, C44.2, C45.2, C46.2, C47.2, C48.2, C49.2, C50.2, C51.2, C52.2, C53.2, C54.2, C55.2, C56.2, C58.2, C59.2, C60.2, C61.2, C62.2, C63.2, D1.1 (A), D2.1 (A), D3.1 (A), D4.1 (A), D5.1 (A), D6.1 (A), D7.2 (A), J1.2, J2.1, J2.2, J3.1, J3.2, J5.3, J5.5, J5.7, J6.2, J6.4, J6.6, J7.3, J7.4, R3.1, R4.1, R6.1, R7.1, R13.2, R14.2, R16.2, R18.2, R23.2, R24.2, R26.2, R28.2, R33.2, R34.2, R36.2, R38.2, R48.2, U1.1 (GND), U1.34 (GND), U1.47 (GND), U2.4 (V-), U3.4 (V-), U4.4 (V-), U5.10 (MIC), U5.11 (MIC_BIAS), U5.21 (GND), U6.10 (MIC), U6.11 (MIC_BIAS), U6.21 (GND), U7.10 (MIC), U7.11 (MIC_BIAS), U7.21 (GND), U8.7 (GND), U9.3 (GND)
MAIN_OUTPUT: J5.4, R9.1
MIDI_OUT: R8.1, U1.3 (1_TX1_CTX2_MISO1)
unnamed: C1.2, R6.2, R9.2
unnamed: C2.2, R3.2, R10.2
unnamed: C3.2, R7.2, R11.2
unnamed: C4.2, R4.2, R12.2
unnamed: C7.2, R19.1
unnamed: C8.2, R20.1
unnamed: C9.2, R21.1, RV1.2, U2.1
unnamed: C10.2, R22.1, RV2.2, U2.7
unnamed: C12.1, C14.2, R21.2
unnamed: C13.1, C15.2, R22.2
unnamed: C18.2, R29.1
unnamed: C19.2, R30.1
unnamed: C20.2, R31.1, RV3.2, U3.1
unnamed: C21.2, R32.1, RV4.2, U3.7
unnamed: C23.1, C25.2, R31.2
unnamed: C24.1, C26.2, R32.2
unnamed: C29.2, R39.1
unnamed: C30.2, R40.1
unnamed: C31.2, R41.1, RV5.2, U4.1
unnamed: C32.2, R42.1, RV6.2, U4.7
unnamed: C34.1, C36.2, R41.2
unnamed: C35.1, C37.2, R42.2
unnamed: C59.1, R46.2
unnamed: C57.1, D7.1 (K), L1.1, U8.8 (PH)
unnamed: J6.1, R10.1
unnamed: J6.3, R11.1
unnamed: J6.5, R12.1
unnamed: C63.1, JP1.1 (A), L1.2, R47.1
unnamed: C5.2, R15.2, R16.1, U2.3 (+)
unnamed: C9.1, R19.2, RV1.1, U2.2 (-)
unnamed: C6.2, R17.2, R18.1, U2.5 (+)
unnamed: C10.1, R20.2, RV2.1, U2.6 (-)
unnamed: C16.2, R25.2, R26.1, U3.3 (+)
unnamed: C20.1, R29.2, RV3.1, U3.2 (-)
unnamed: C17.2, R27.2, R28.1, U3.5 (+)
unnamed: C21.1, R30.2, RV4.1, U3.6 (-)
unnamed: C27.2, R35.2, R36.1, U4.3 (+)
unnamed: C31.1, R39.2, RV5.1, U4.2 (-)
unnamed: C28.2, R37.2, R38.1, U4.5 (+)
unnamed: C32.1, R40.2, RV6.1, U4.6 (-)
unnamed: R43.1, U5.13 (SYS_MCLK)
unnamed: C41.1, U5.5 (VAG)
unnamed: C42.1, C43.1, FB1.2, U5.3 (VDDA)
unnamed: R44.1, U6.13 (SYS_MCLK)
unnamed: C47.1, U6.5 (VAG)
unnamed: C48.1, C49.1, FB2.2, U6.3 (VDDA)
unnamed: R45.1, U7.13 (SYS_MCLK)
unnamed: C53.1, U7.5 (VAG)
unnamed: C54.1, C55.1, FB3.2, U7.3 (VDDA)
unnamed: C57.2, U8.1 (BOOT)
unnamed: C61.1, R46.1, U8.6 (COMP)
unnamed: C58.1, U8.4 (SS)
unnamed: R47.2, R48.1, U8.5 (VSENSE)
