mattybrad/bjarkardottir2/pcb/fretboard/fretboard.kicad_pcb

## KiCad design pcb/fretboard/fretboard.kicad_pcb (2025-02-12)

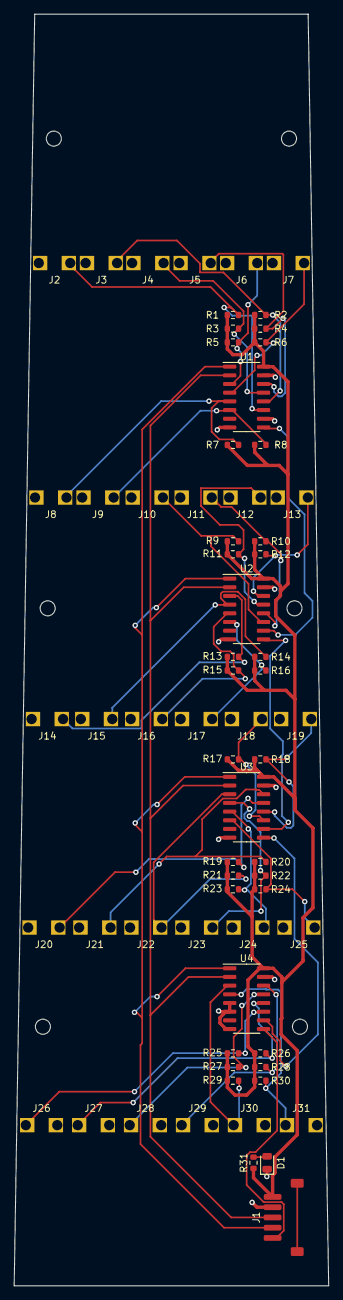
[picture p14: board fretboard.kicad_pcb from above]

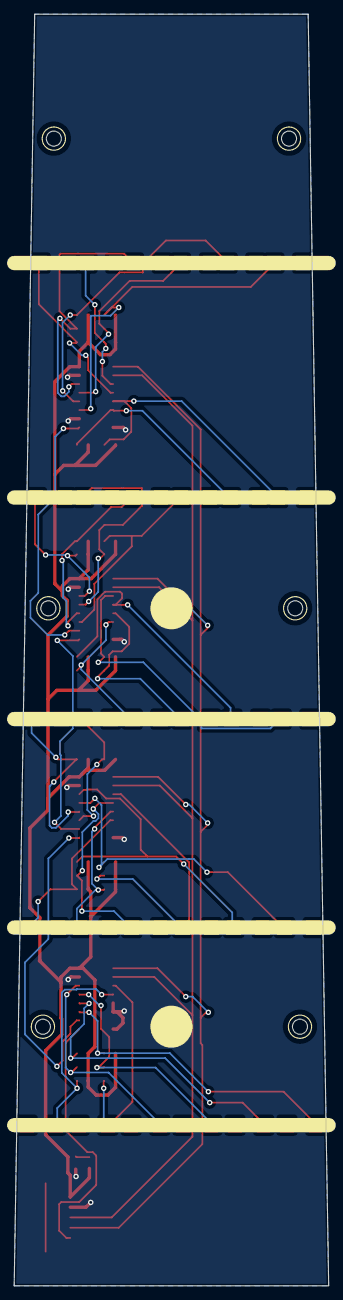
[picture p15: board fretboard.kicad_pcb from below]

Board: 2 copper layers, 46.0 x 186.0 mm, 73 parts (6 on the bottom side), 39 nets.

Parts:
D1: LED; LED_0805_2012Metric
H1, H2, H3, H4, H5, H6: MountingHole; MountingHole_2.2mm_M2_countersunk
J1: Conn_01x06_Pin; jst zh fretboard connector
J2, J3, J4, J5, J6, J7, J8, J9, J10, J11, J12, J13, J14, J15, J16, J17, J18, J19, J20, J21, J22, J23, J24, J25, J26, J27, J28, J29, J30, J31: Conn_01x01_Pin; Bjarkar_fret_connection
R1, R2, R3, R4, R5, R6, R7, R8, R9, R10, R11, R12, R13, R14, R15, R16, R17, R18, R19, R20, R21, R22, R23, R24, R25, R26, R27, R28, R29, R30: 10k; R_0603_1608Metric
R31: 220R; R_0603_1608Metric
U1, U2, U3, U4: 74HC165; SOIC-16_3.9x9.9mm_P1.27mm

Connections:
165_CLOCK: J1.3, U1.2 (CP), U2.2 (CP), U3.2 (CP), U4.2 (CP)
165_LOAD: J1.4, U1.1 (~PL), U2.1 (~PL), U3.1 (~PL), U4.1 (~PL)
+3.3V: J1.1, R1.1, R2.1, R3.1, R4.1, R5.1, R6.1, R7.1, R8.1, R9.1, R10.1, R11.1, R12.1, R13.1, R14.1, R15.1, R16.1, R17.1, R18.1, R19.1, R20.1, R21.1, R22.1, R23.1, R24.1, R25.1, R26.1, R27.1, R28.1, R29.1, R30.1, R31.1, U1.16 (VCC), U2.16 (VCC), U3.16 (VCC), U4.16 (VCC)
/ShiftReg1/DATA_OUT: U1.9 (Q7), U2.10 (DS)
/ShiftReg2/DATA_OUT: U2.9 (Q7), U3.10 (DS)
/ShiftReg3/DATA_OUT: U3.9 (Q7), U4.10 (DS)
/ShiftReg4/DATA_OUT: J1.5, U4.9 (Q7)
GND: D1.1 (K), J1.2, U1.8 (GND), U1.10 (DS), U1.15 (~CE), U2.8 (GND), U2.15 (~CE), U3.8 (GND), U3.15 (~CE), U4.5 (D6), U4.6 (D7), U4.8 (GND), U4.15 (~CE)
unnamed: D1.2 (A), R31.2
unnamed: J2.1, R1.2, U1.11 (D0)
unnamed: J3.1, R2.2, U1.12 (D1)
unnamed: J4.1, R3.2, U1.13 (D2)
unnamed: J5.1, R4.2, U1.14 (D3)
unnamed: J6.1, R5.2, U1.3 (D4)
unnamed: J7.1, R6.2, U1.4 (D5)
unnamed: J8.1, R7.2, U1.5 (D6)
unnamed: J9.1, R8.2, U1.6 (D7)
unnamed: J10.1, R9.2, U2.11 (D0)
unnamed: J11.1, R10.2, U2.12 (D1)
unnamed: J12.1, R11.2, U2.13 (D2)
unnamed: J13.1, R12.2, U2.14 (D3)
unnamed: J14.1, R13.2, U2.3 (D4)
unnamed: J15.1, R14.2, U2.4 (D5)
unnamed: J16.1, R15.2, U2.5 (D6)
unnamed: J17.1, R16.2, U2.6 (D7)
unnamed: J18.1, R17.2, U3.11 (D0)
unnamed: J19.1, R18.2, U3.12 (D1)
unnamed: J20.1, R19.2, U3.13 (D2)
unnamed: J21.1, R20.2, U3.14 (D3)
unnamed: J22.1, R21.2, U3.3 (D4)
unnamed: J23.1, R22.2, U3.4 (D5)
unnamed: J24.1, R23.2, U3.5 (D6)
unnamed: J25.1, R24.2, U3.6 (D7)
unnamed: J26.1, R25.2, U4.11 (D0)
unnamed: J27.1, R26.2, U4.12 (D1)
unnamed: J28.1, R27.2, U4.13 (D2)
unnamed: J29.1, R28.2, U4.14 (D3)
unnamed: J30.1, R29.2, U4.3 (D4)
unnamed: J31.1, R30.2, U4.4 (D5)
