mattybrad/bjarkardottir2/(commit log)

2024-11-12 here we go again
    [bridge.FCStd, bridge.stl, bridgecnc.FCStd, fretboard.kicad_pcb, fretboard.kicad_sch, fretboard1.FCStd, shiftreg.kicad_sch, shiftregx.kicad_sch]
2024-11-12 started body pcb
    [body.kicad_pcb, body.kicad_sch]
2024-11-19 pcb stuff
    [pickuppair.kicad_sch]
2024-11-19 output stage
    [body.kicad_sch, outputstage.kicad_sch, pickuppair.kicad_sch]
2025-01-28 connector breakout
    [gk3_breakout.kicad_pcb, gk3_breakout.kicad_sch]
2025-01-29 linked input stages to codecs
    [body.kicad_sch, codec.kicad_sch, pickuppair.kicad_sch]
2025-01-30 not much
    [body.kicad_sch]
2025-01-31 nice progress
    [body.kicad_pcb, body.kicad_sch, codec.kicad_sch, pickuppair.kicad_sch, power.kicad_sch]
2025-02-03 initial layout
    [body.kicad_pcb, body.kicad_sch]
2025-02-04 lots more layout
    [body.kicad_pcb, body.kicad_sch, pickuppair.kicad_sch, power.kicad_sch]
2025-02-04 more layout...
    [body.kicad_pcb]
2025-02-05 haven't committed for a bit
    [body.kicad_pcb, body.kicad_sch, codec.kicad_sch, pickuppair.kicad_sch, power.kicad_sch, strat_with_pcb.FCStd]
2025-02-05 first four layer board...
    [body.kicad_pcb]
2025-02-05 4 layer routing...
    [body.kicad_pcb]
2025-02-07 routing going well with 4 layers
    [body.kicad_pcb]
2025-02-07 zero unrouted for now
    [body.kicad_pcb]
2025-02-10 getting there
    [body.kicad_pcb, body.kicad_sch, codec.kicad_sch, fretboard.kicad_pcb, power.kicad_sch]
2025-02-10 fretboard routing
    [fretboard.kicad_pcb]
2025-02-11 faffing with fretboard
    [fretboard.kicad_pcb, shiftreg.kicad_sch, shiftregx.kicad_sch]
2025-02-11 fretboard routing done
    [fretboard.kicad_pcb]
2025-02-12 fretboard finished
    [BOM-fretboard.csv, S5B-ZR-SM4A-TF.STEP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]
2025-02-14 body pcb zero errors
    [body.kicad_pcb, body.kicad_sch]
2025-02-14 body pcb done
    [BOM-body.csv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]
2025-02-17 body done
    [body.kicad_pcb]
2025-04-18 nicer layout
    [audio.kicad_sch, body2.kicad_pcb, body2.kicad_sch, pickuppair.kicad_sch]
2025-04-20 more layout
    [body2.kicad_pcb]
2025-04-20 replicate layout plugin not working
    [body2.kicad_pcb]
2025-04-22 kicad 9
    [audio.kicad_sch, body2.kicad_pcb, body2.kicad_sch, codec.kicad_sch, pickuppair.kicad_sch, power.kicad_sch]
2025-04-29 routing mainly done
    [body2.kicad_pcb]
2025-04-29 zero errors
    [body2.kicad_pcb]
2025-05-02 pcb 2 done
    [BOM-body.csv, BOM-body2.csv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]
2025-06-07 pcb v2.1 works really well!!!
    [BOM-body2.csv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]
